theozas/ProjectLog/Resources/IMG_20200223_143447.jpg

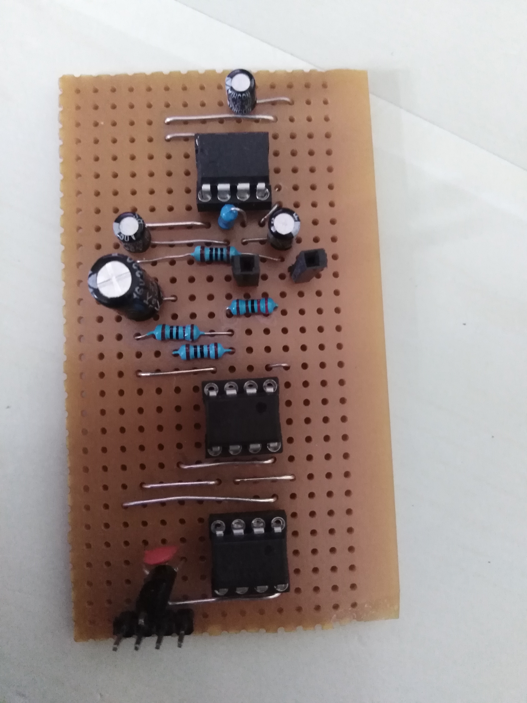
Resources/IMG_20200223_143447.jpg
