theozas/ProjectLog/Resources/IMG_20191127_142721.jpg

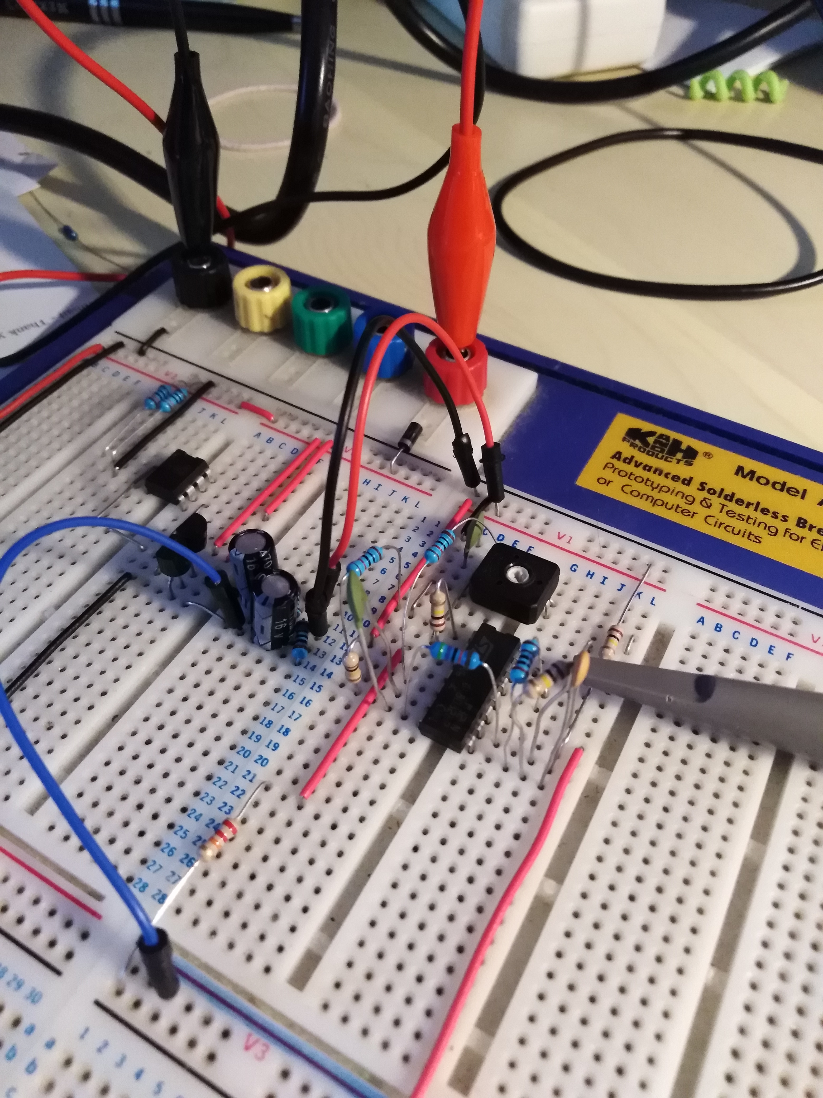
Resources/IMG_20191127_142721.jpg
