theozas/ProjectLog/Resources/1.-Transistor-symbols.jpg

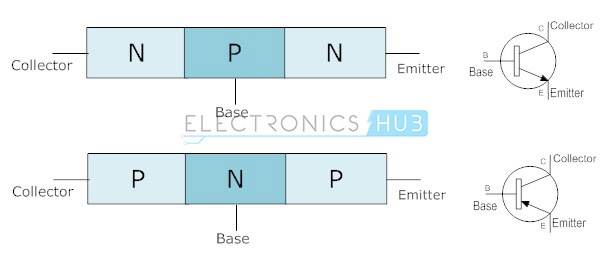
Resources/1.-Transistor-symbols.jpg
