theozas/ProjectLog/Resources/60-4e07478d2c.webp

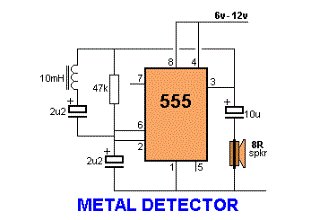
Resources/60-4e07478d2c.webp
