theozas/ProjectLog/Resources/1280px-Freertos.svg.png

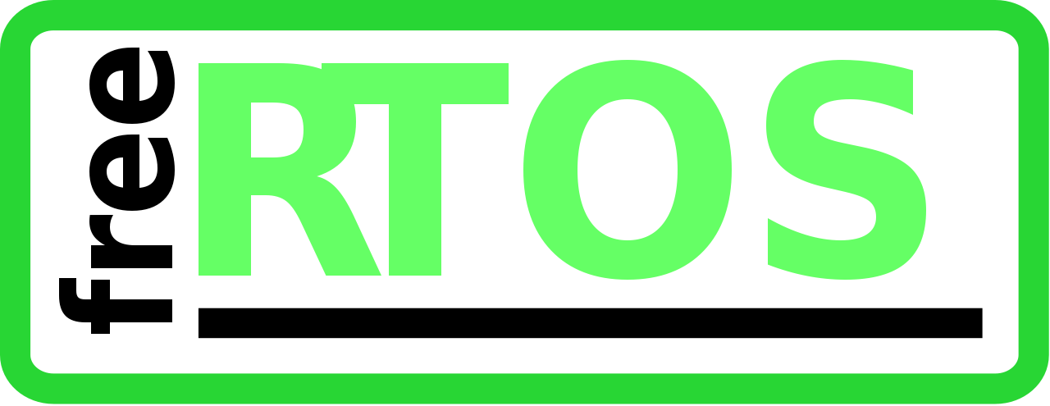
Resources/1280px-Freertos.svg.png
