theozas/ProjectLog/Resources/FGHOC6AJ7AQS3J2.LARGE.jpg.webp

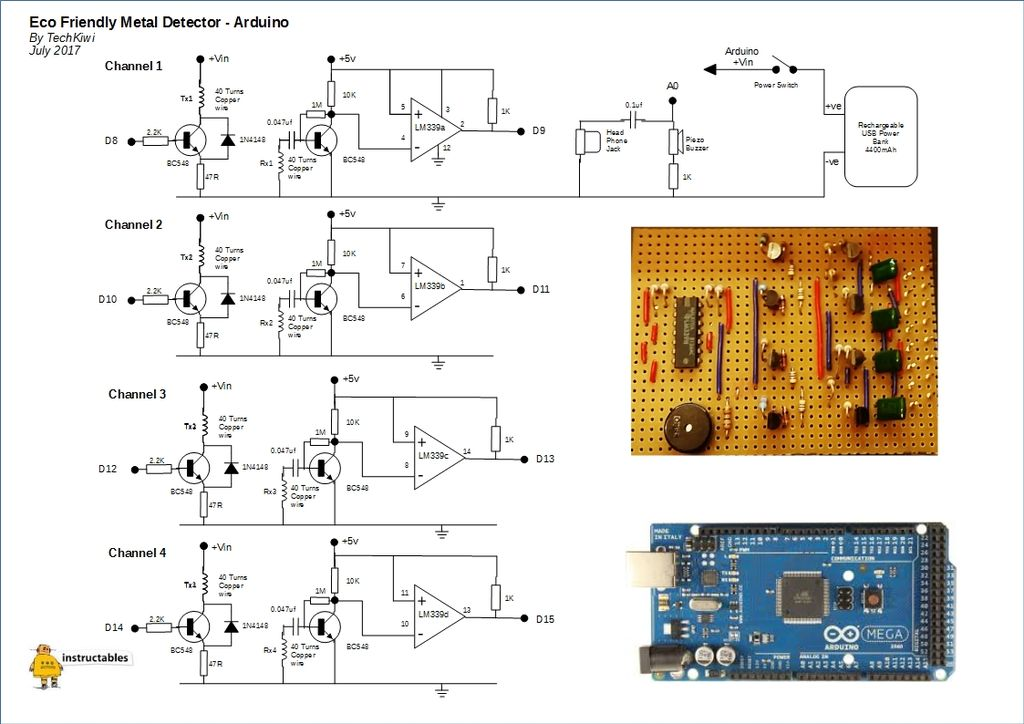
Resources/FGHOC6AJ7AQS3J2.LARGE.jpg.webp
