theozas/ProjectLog/Resources/IMG-20200320-WA0009.jpg

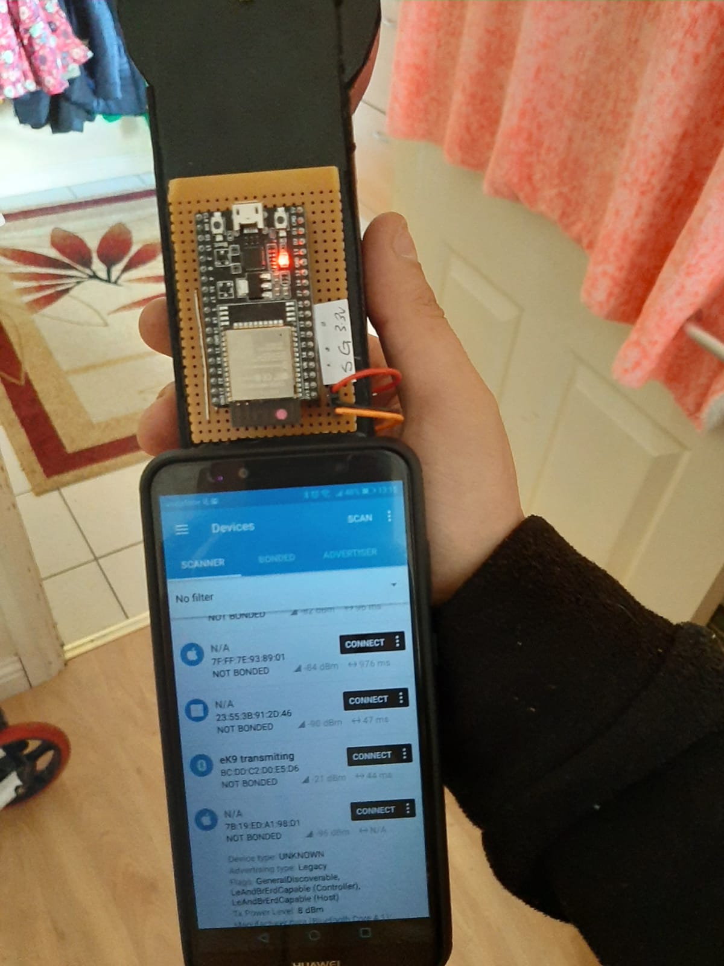
Resources/IMG-20200320-WA0009.jpg
