theozas/ProjectLog/Resources/IMG_20191103_180938.jpg

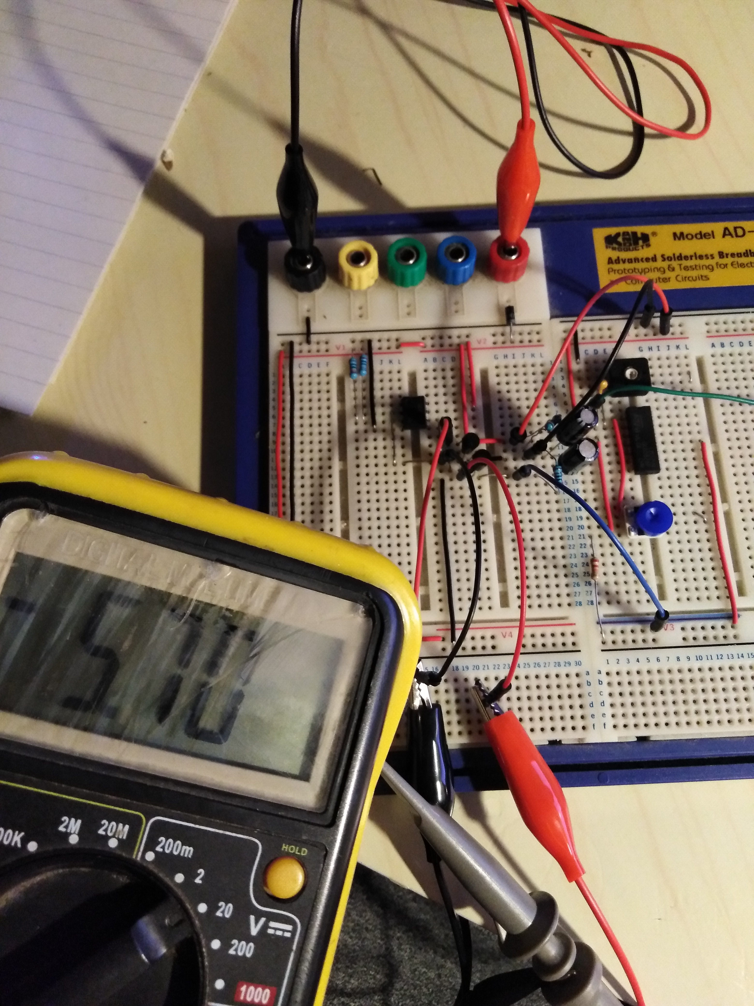
Resources/IMG_20191103_180938.jpg
