theozas/ProjectLog/Resources/IMG_20191103_181004.jpg

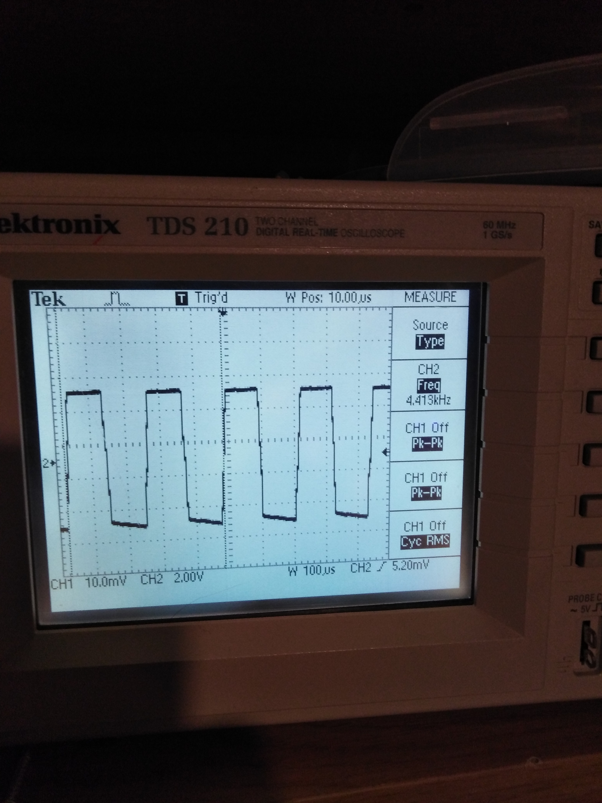
Resources/IMG_20191103_181004.jpg
