theozas/ProjectLog/Resources/IMG_20191103_181326.jpg

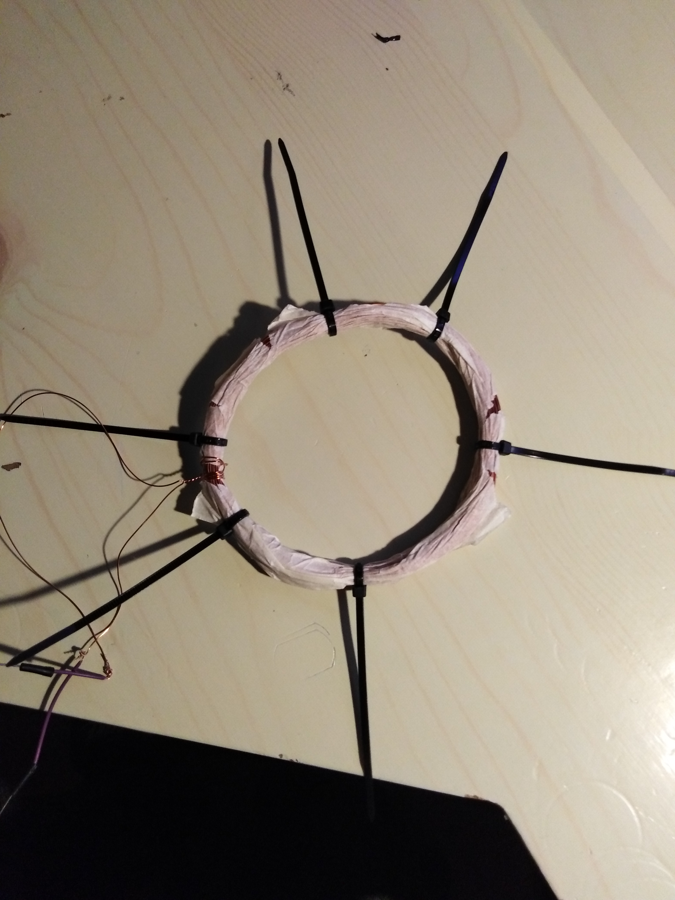
Resources/IMG_20191103_181326.jpg
