theozas/ProjectLog/Resources/IMG_20191127_142724.jpg

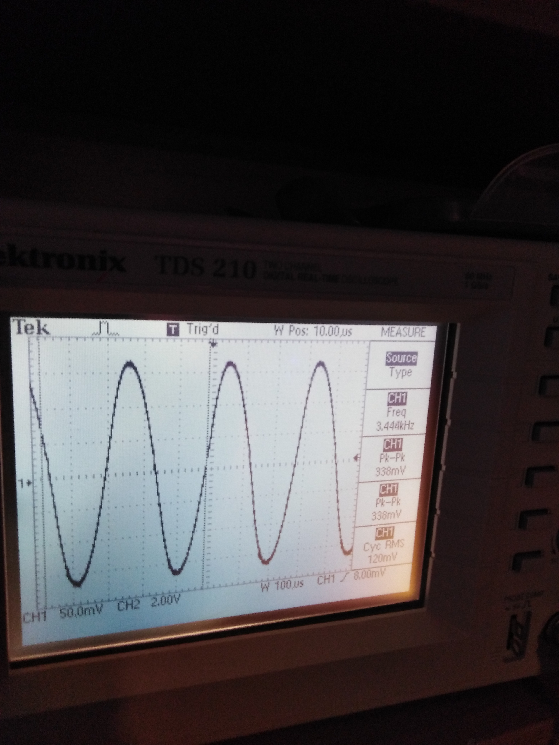
Resources/IMG_20191127_142724.jpg
