theozas/ProjectLog/Resources/IMG_20191127_153622.jpg

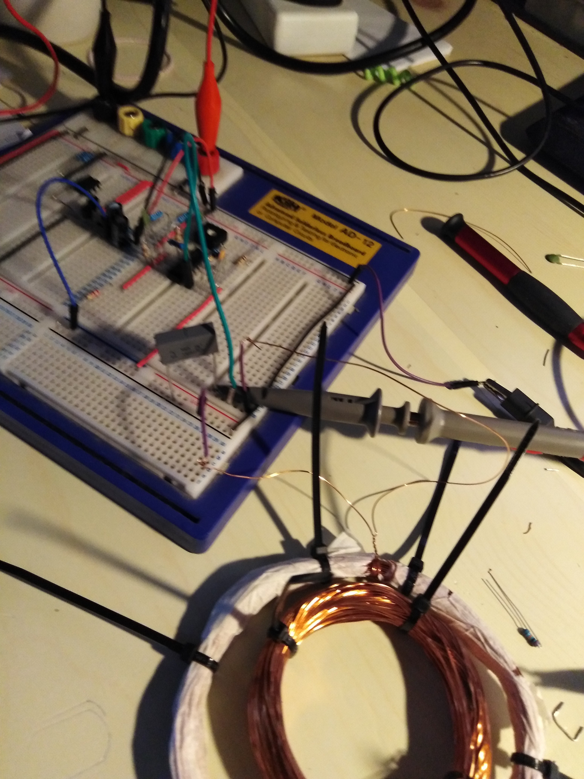
Resources/IMG_20191127_153622.jpg
