theozas/ProjectLog/Resources/IMG_20191127_153626.jpg

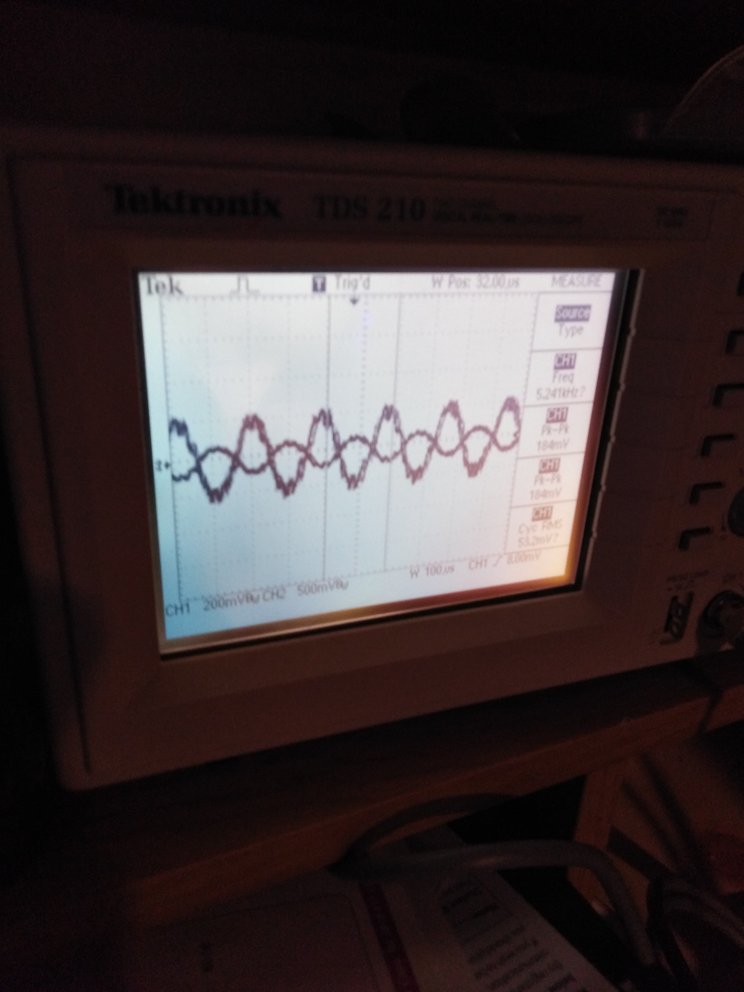
Resources/IMG_20191127_153626.jpg
