theozas/ProjectLog/Resources/IMG_20200214_193923.jpg

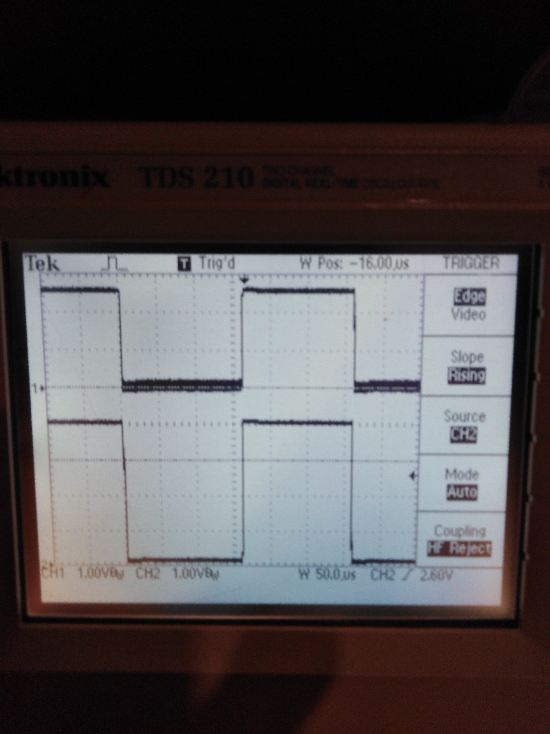
Resources/IMG_20200214_193923.jpg
