theozas/ProjectLog/Resources/IMG_20200214_193930.jpg

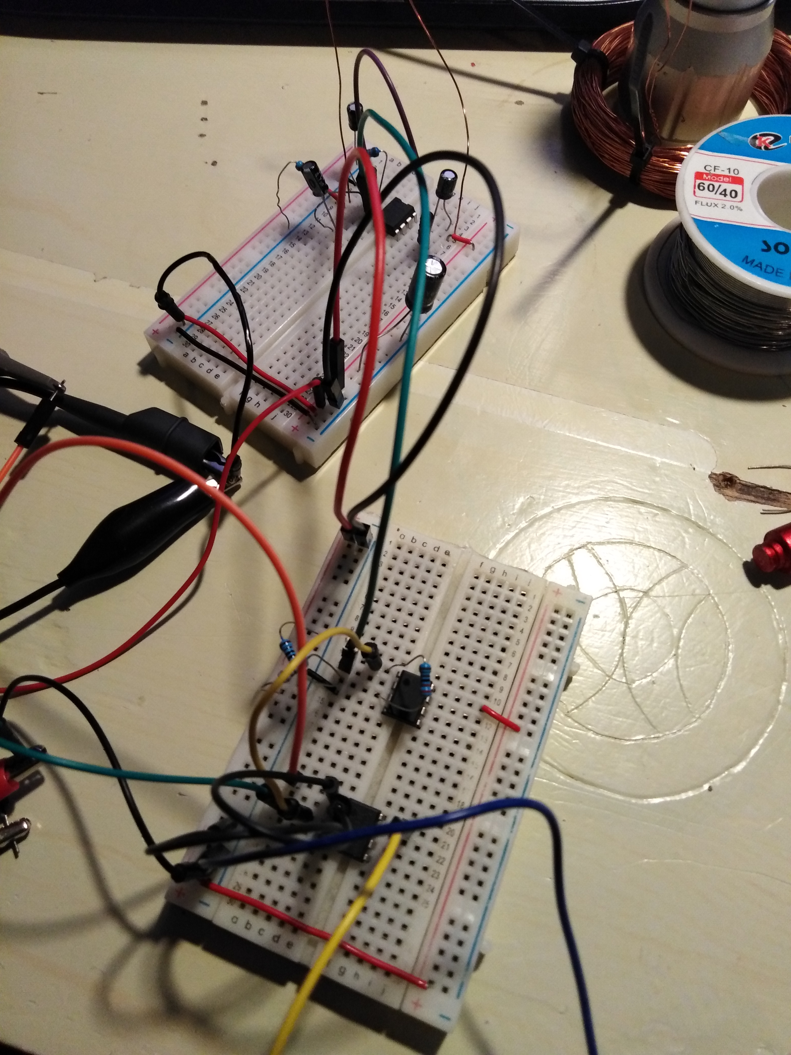
Resources/IMG_20200214_193930.jpg
