theozas/ProjectLog/Resources/IMG_20200214_194050.jpg

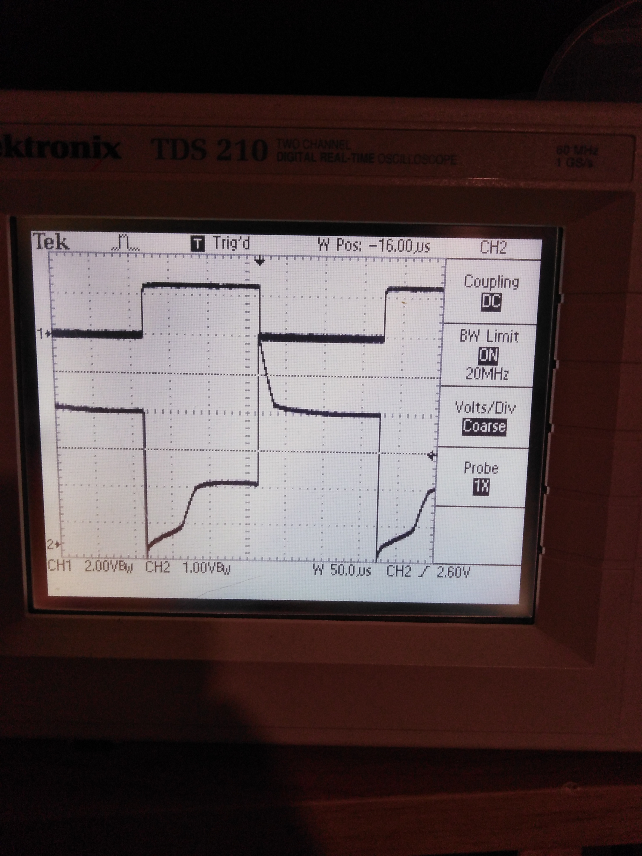
Resources/IMG_20200214_194050.jpg
