theozas/ProjectLog/Resources/IMG_20200223_143458.jpg

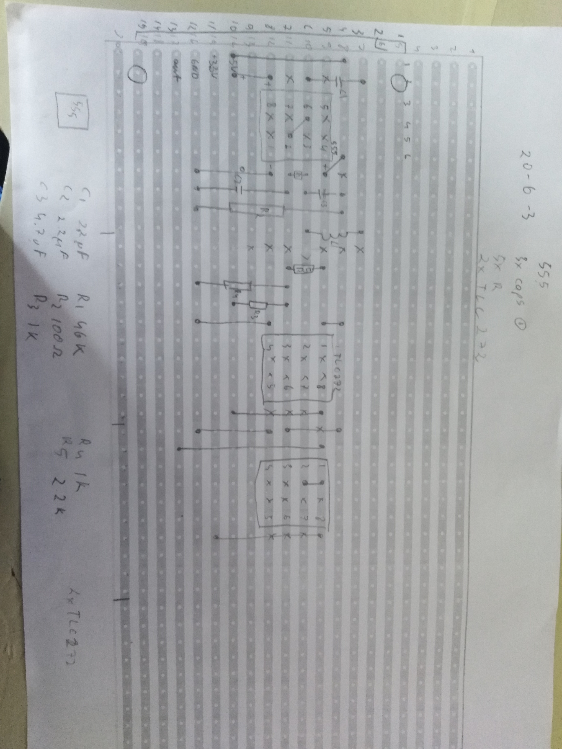
Resources/IMG_20200223_143458.jpg
