theozas/ProjectLog/Resources/IMG_20200304_180144.jpg

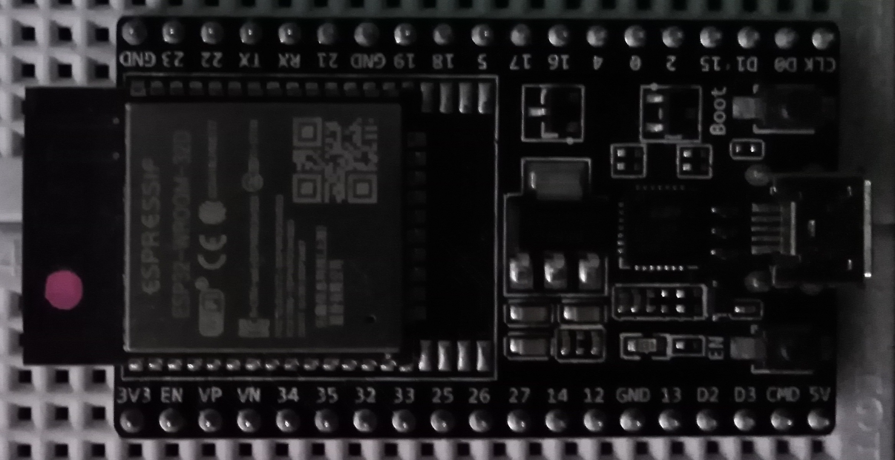
Resources/IMG_20200304_180144.jpg
