theozas/ProjectLog/Resources/IMG_20200320_122804.jpg

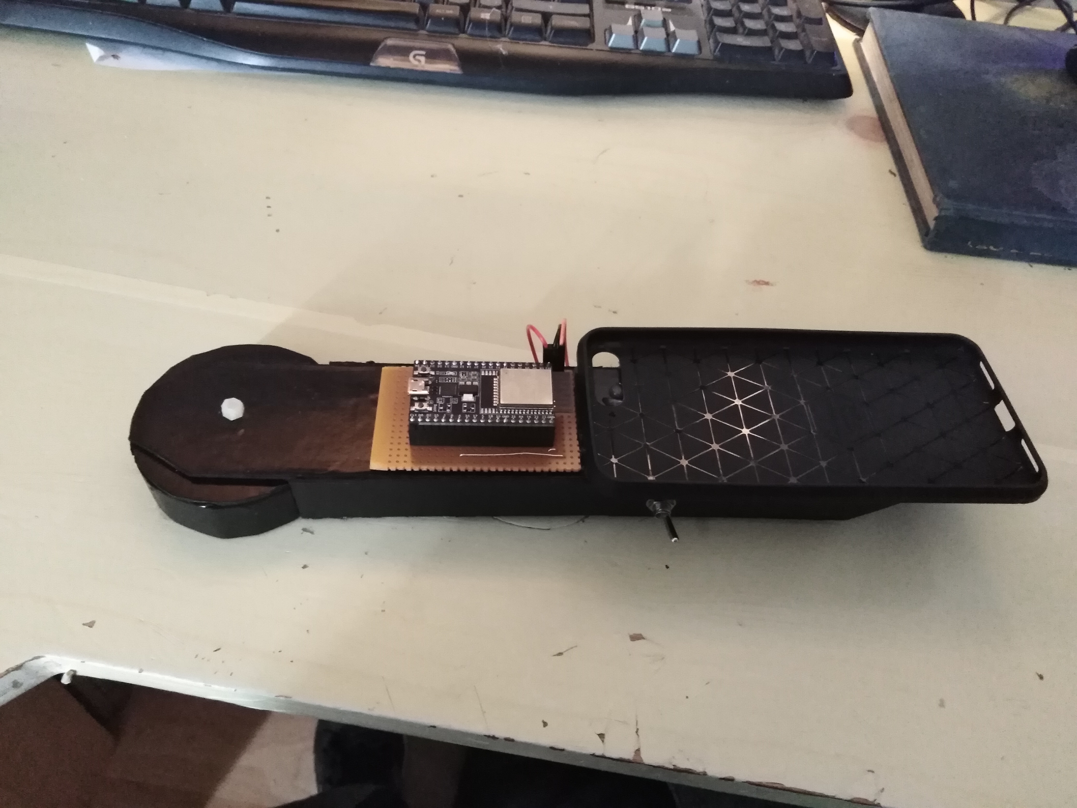
Resources/IMG_20200320_122804.jpg
