theozas/ProjectLog/Resources/IMG_20200320_122825.jpg

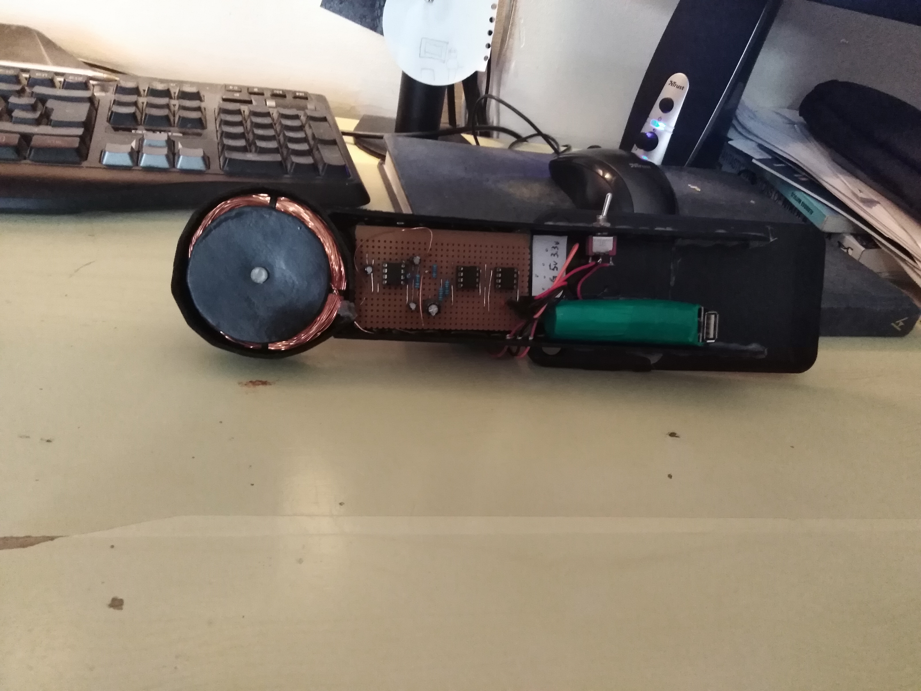
Resources/IMG_20200320_122825.jpg
