theozas/ProjectLog/Resources/Rail spliter1.PNG

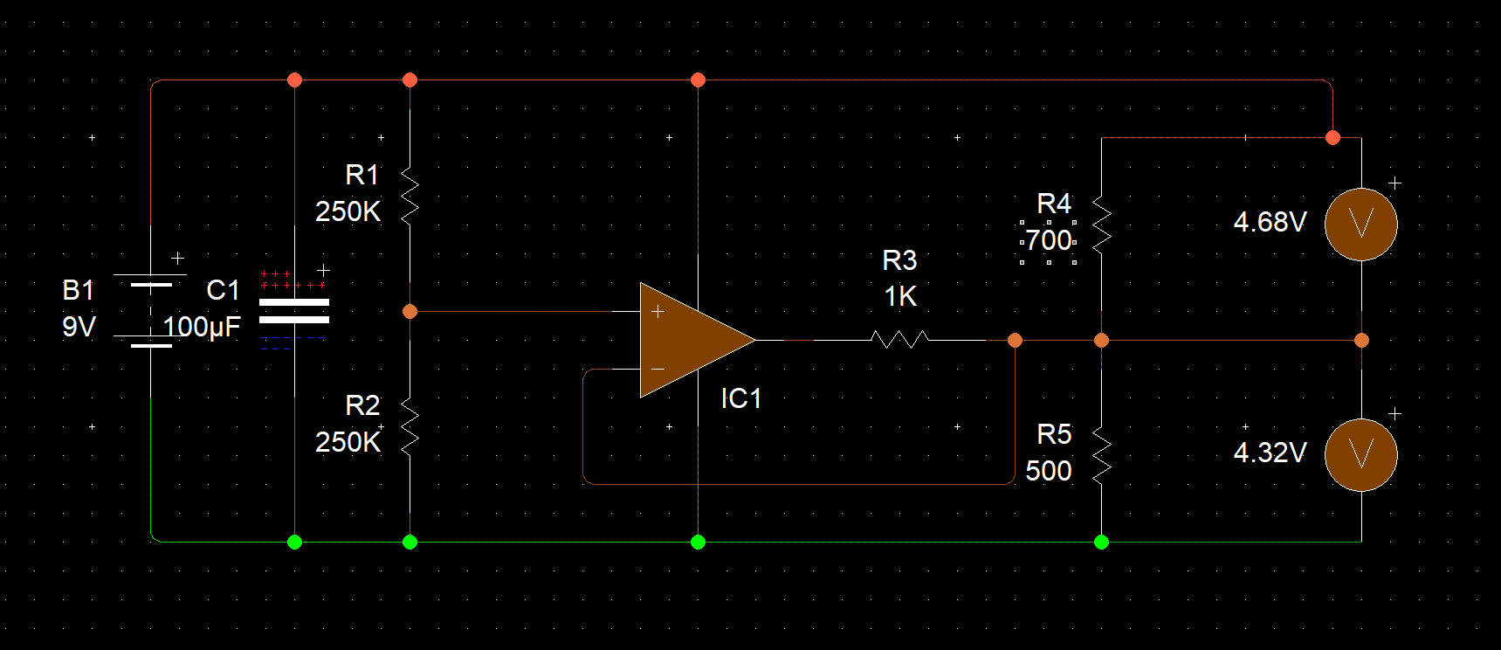
Resources/Rail spliter1.PNG
