theozas/ProjectLog/ProjectFiles/Hardware/ProjectMetalDetector.pdf

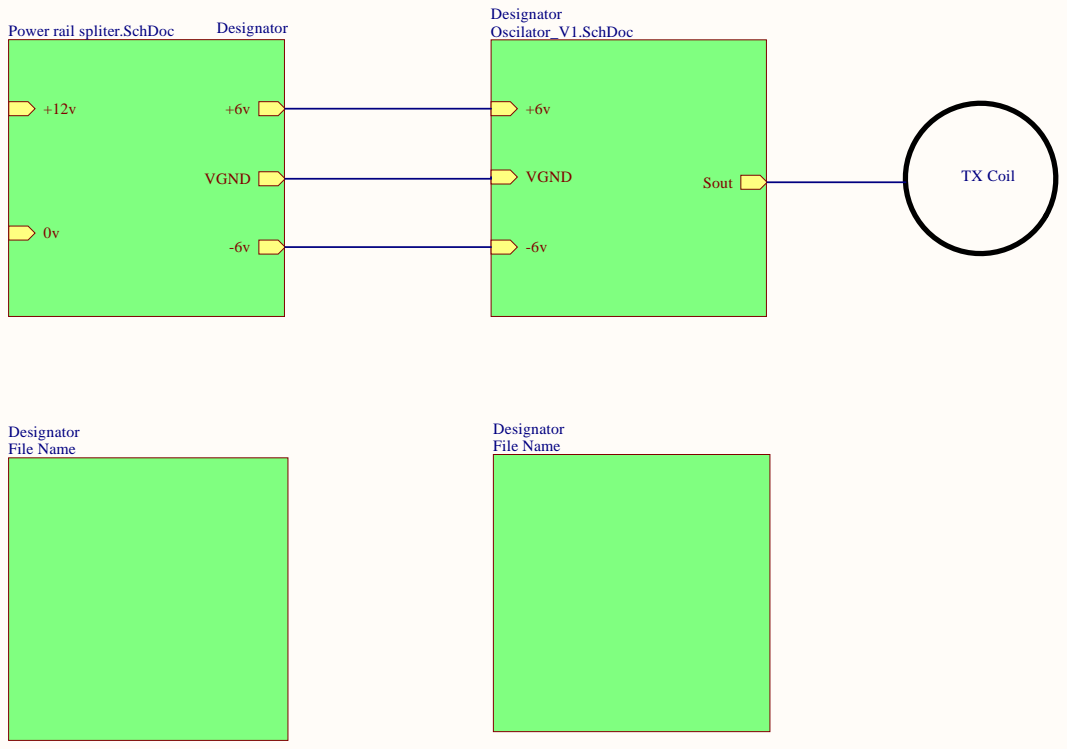
[picture p80: page 1]

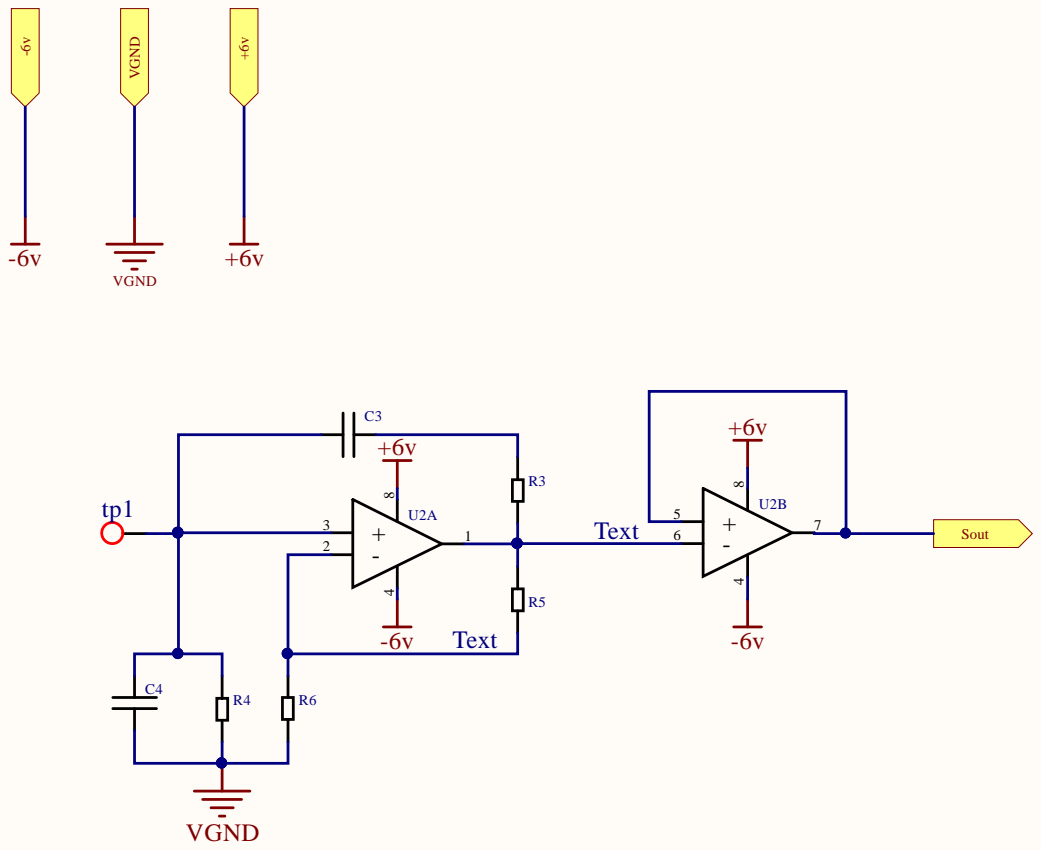
[picture p81: page 2]

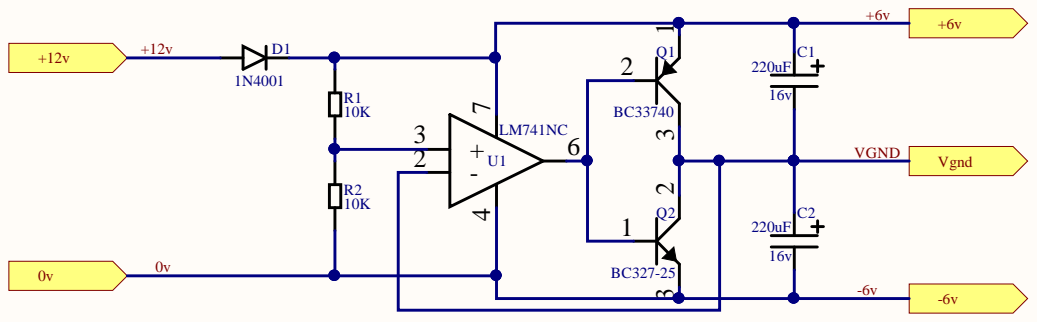
[picture p82: page 3]
