theozas/ProjectLog/Resources/MetalDetectorHardvare/Metal sensor.pdf

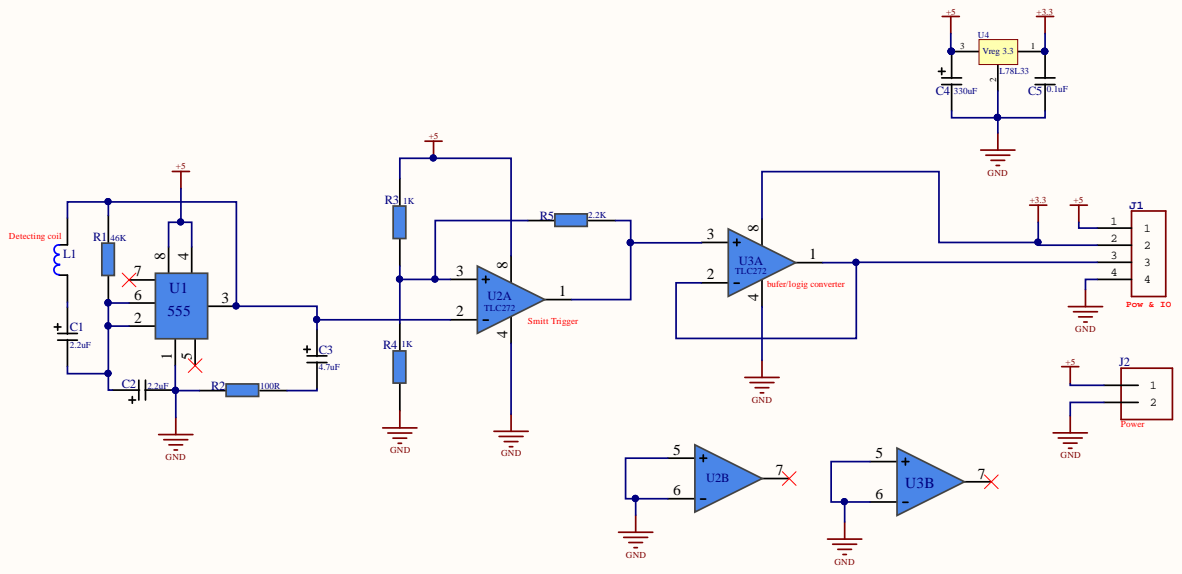
[picture p83: page 1]
