theozas/ProjectLog/Resources/MetalDetectorHardvare/ProjectMetalDetector_v1.pdf

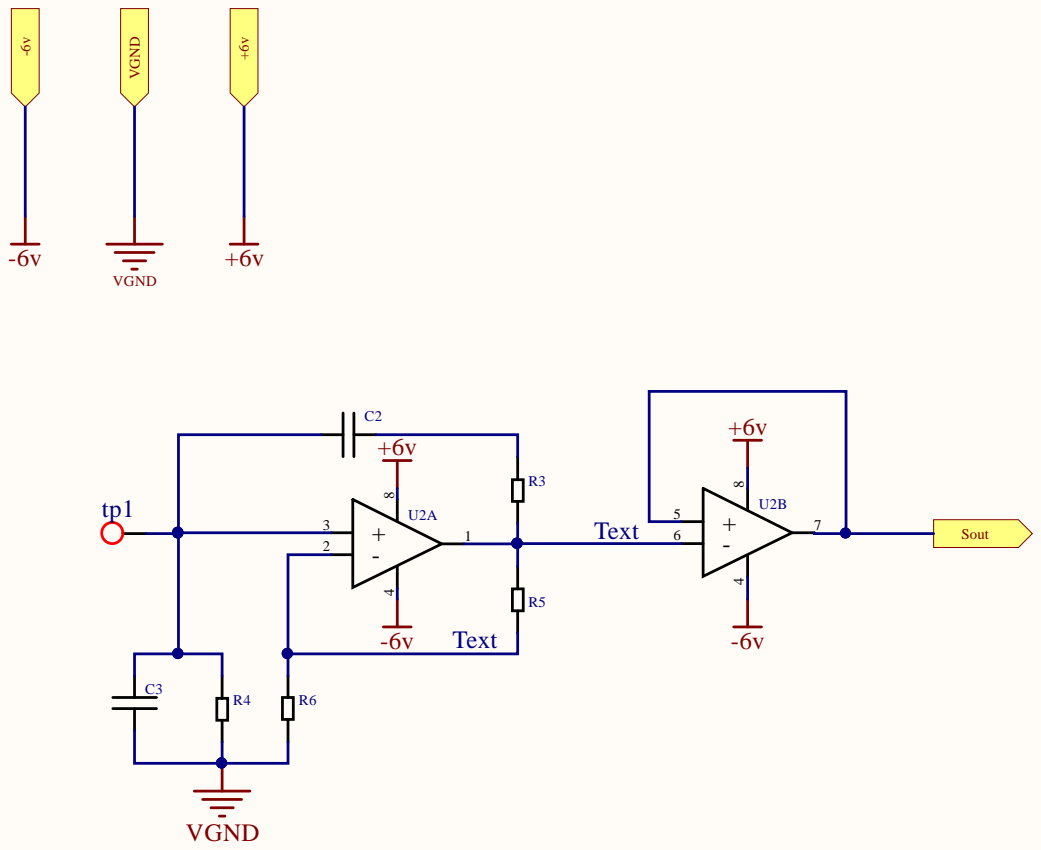
[picture p84: page 2]
