theozas/ProjectLog/(list of files, drawings)

Other design files:
Resources/MetalDetectorHardvare/Metal sensor.SchDoc
Resources/MetalDetectorHardvare/PlaneSheet.SchDoc
